Jalle86/slowcooker/front.jpg

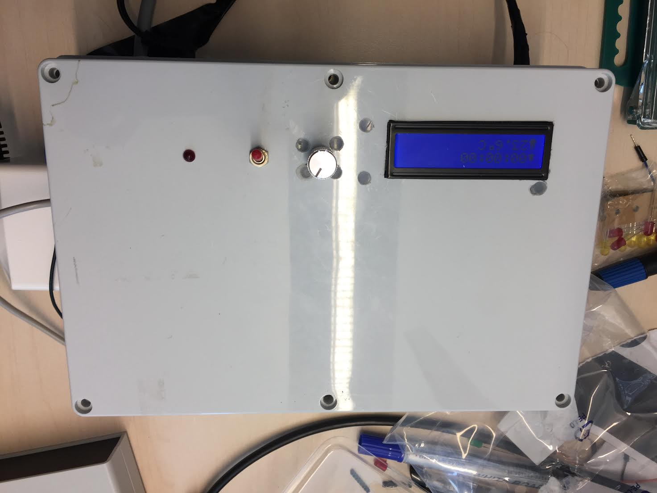
front.jpg
