Jalle86/slowcooker/compare.JPG

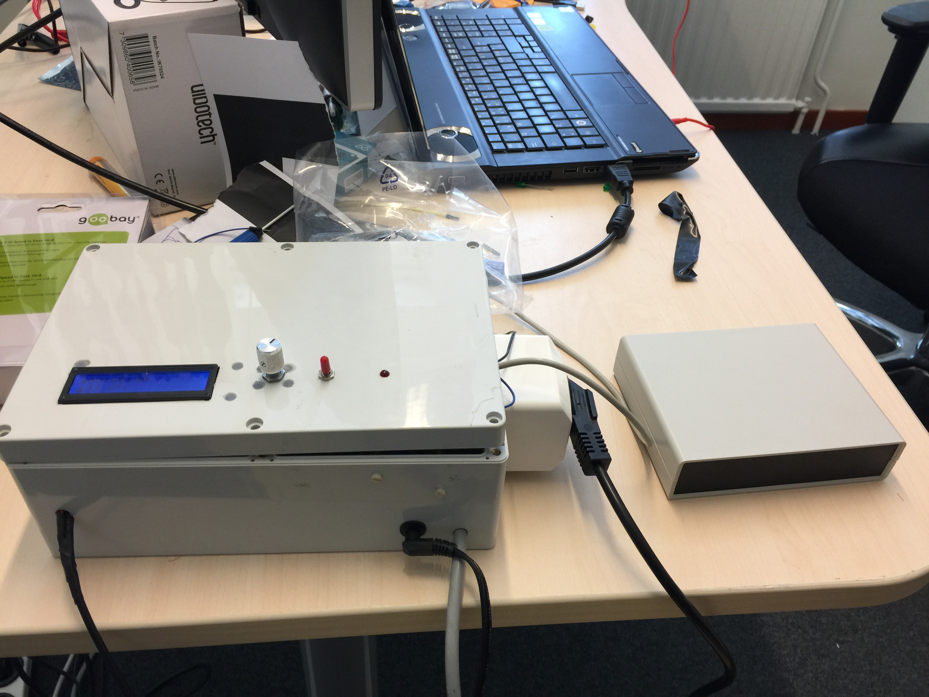
compare.JPG
