Jalle86/slowcooker/Bucketlist.txt

* Mät temperatur
* Ändra/reglera temperatur

* Anslut med BT
* Anslut med WiFi

* Kalibrera tempmätare
* Timer, programinställningar.
* Förbättrad temperaturreglering.
* Hantera kontaktstudsar (hårdvara)

* Paketera/krympa systemet. (mindre pic-processor?)

* BT/WiFi GUI?
