Jalle86/slowcooker/box1.JPG

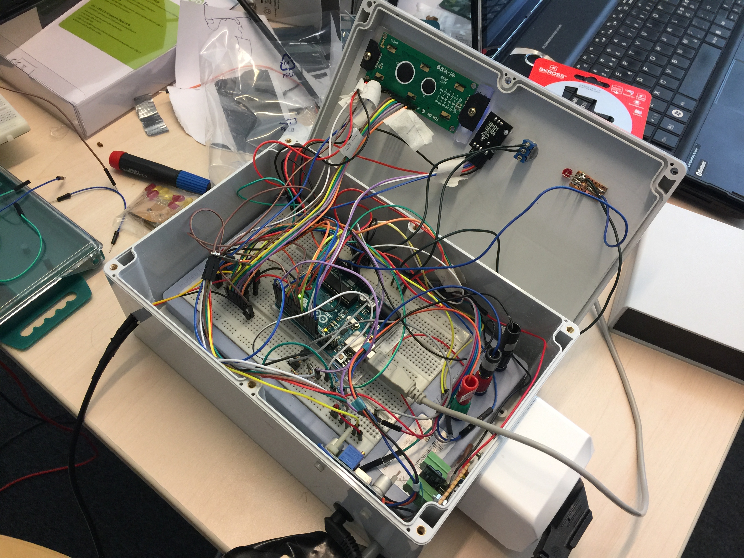
box1.JPG
