Jalle86/slowcooker/box2.JPG

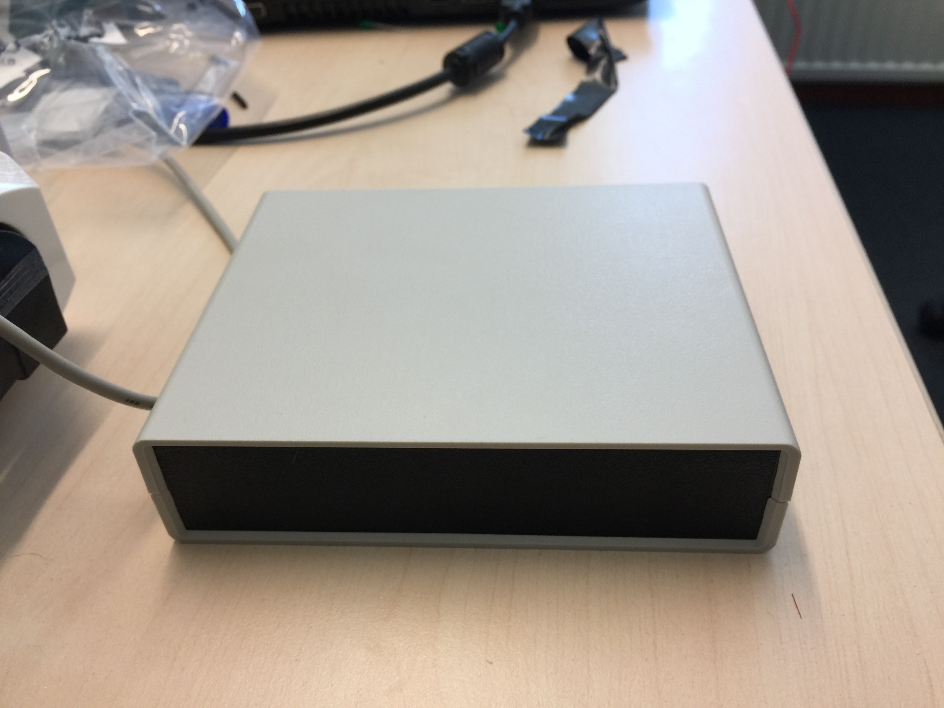
box2.JPG
