Jalle86/slowcooker/cooker_pcb.png

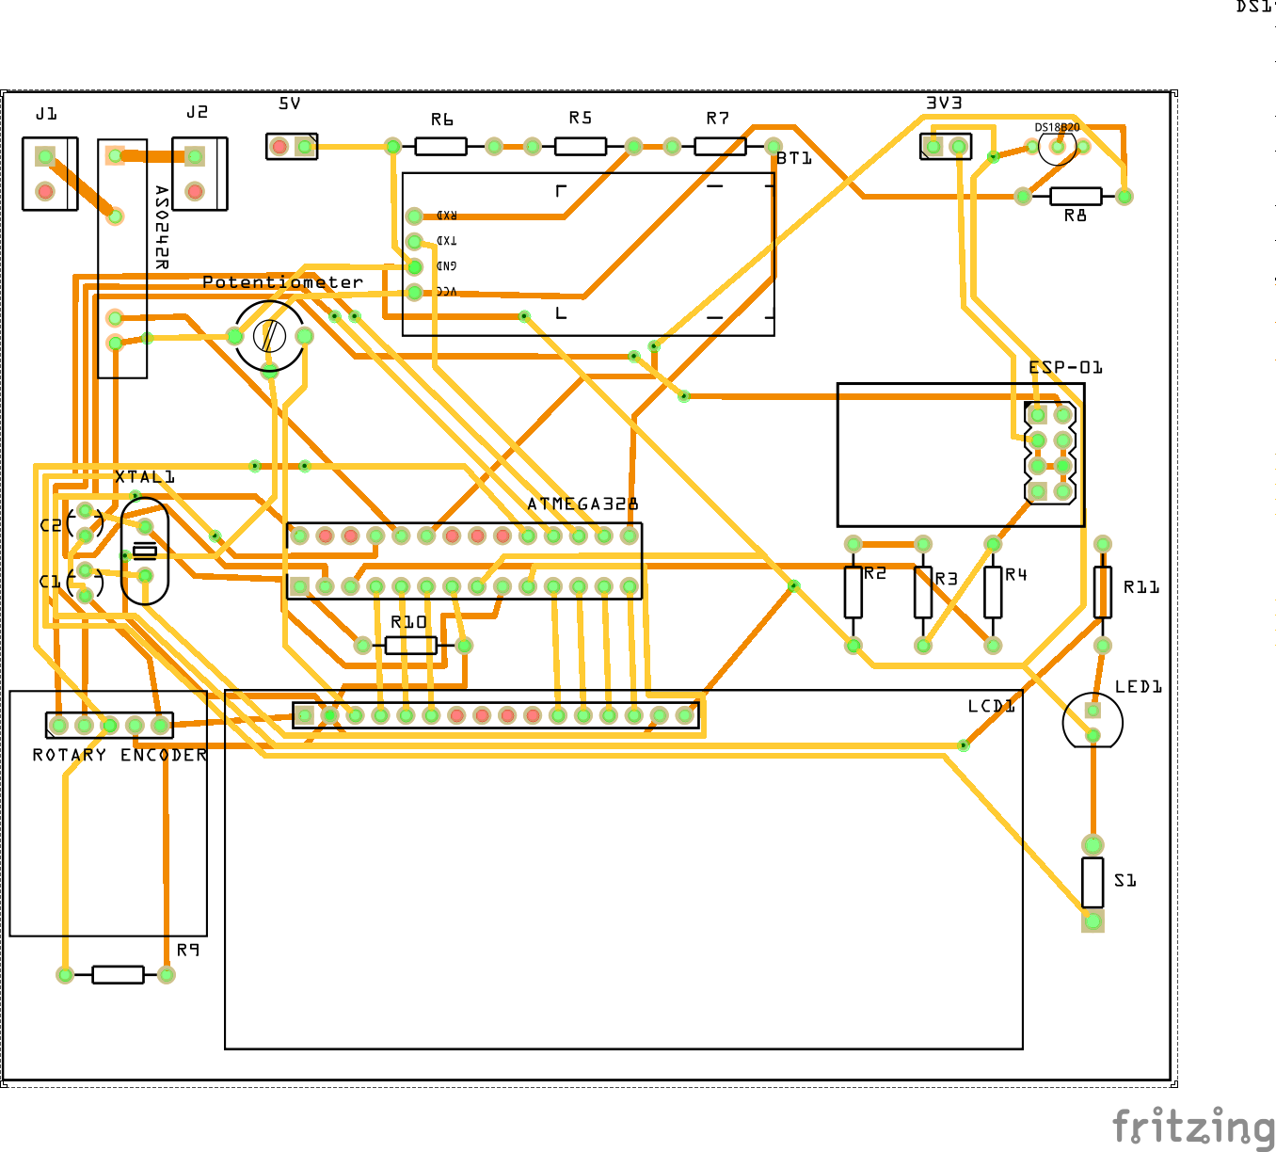
cooker_pcb.png
