Jalle86/slowcooker/metod.png

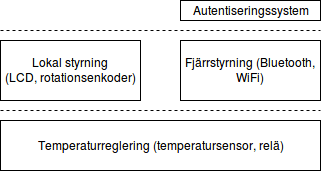
metod.png
