Jalle86/slowcooker/Rotary-Encoder-Phases.png

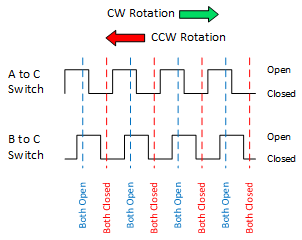
Rotary-Encoder-Phases.png
