Jalle86/slowcooker/Rotary-Encoder-Representation.png

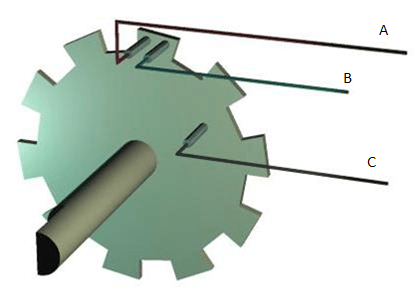
Rotary-Encoder-Representation.png
