Jalle86/slowcooker/Screenshot_2017-06-15-10-20-41.png

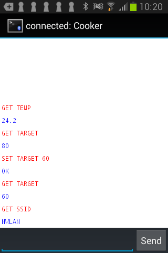
Screenshot_2017-06-15-10-20-41.png
