Jalle86/slowcooker/Screenshot_20170615-105420.png

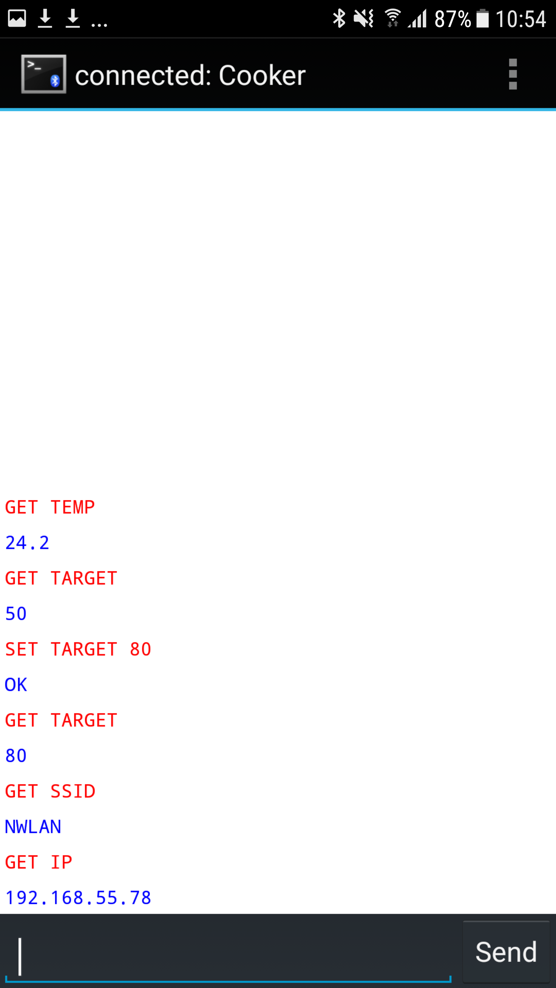
Screenshot_20170615-105420.png
