Jalle86/slowcooker/(list of files, drawings)

Other design files:
fritzing/cooker.fzz
