Jalle86/slowcooker/kicad/cooker.kicad_pcb

## KiCad design kicad/cooker.kicad_pcb (2017-05-29)

Schematic: cooker.sch

Parts:
R1, R2, R3: R
U1: ESP-01V090

Connections:
+3.3V: U1.3, U1.4, U1.5, U1.6, U1.7
unnamed: R1.2, R2.2
unnamed: R2.1, R3.1, U1.1

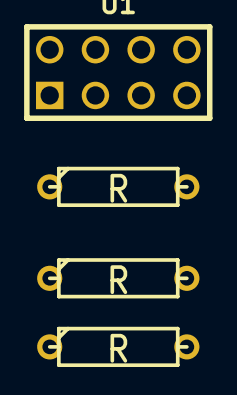
[picture p18: board cooker.kicad_pcb from above]

Board: 2 copper layers, 4 parts (0 on the bottom side), 3 nets, no tracks yet.
