Jalle86/slowcooker/(commit log)

2017-05-31 massa krejjer
    [cooker.fzz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]
2017-06-01 int så mkt...
    [cooker.fzz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]
2017-06-08 lotsa stuff
    [cooker.fzz]
2017-06-13 final stretch
    [cooker.fzz]
2017-06-14 wooop :o
    [cooker.fzz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]
